curiouselectric/therm-o-nator/README.md

# therm-o-nator
A temperature sensing thermocouple amplifier kit
