curiouselectric/therm-o-nator/Thermocouple_Instructions/Thermocouple_schematic.png

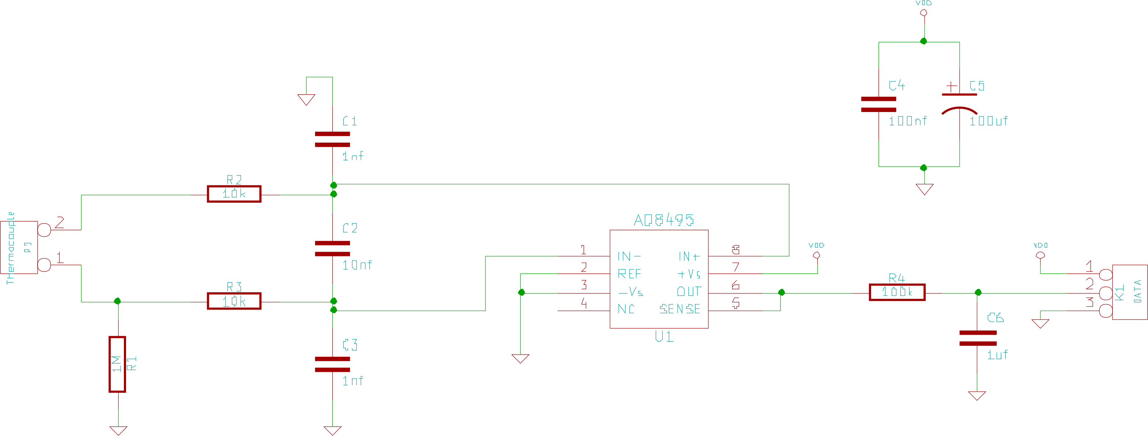
Thermocouple_Instructions/Thermocouple_schematic.png
