curiouselectric/therm-o-nator/Thermocouple_PCB/AD8495_Thermocouple_PCB_x1_30_11_13.kicad_pcb

## KiCad design Thermocouple_PCB/AD8495_Thermocouple_PCB_x1_30_11_13.kicad_pcb (2015-11-30)

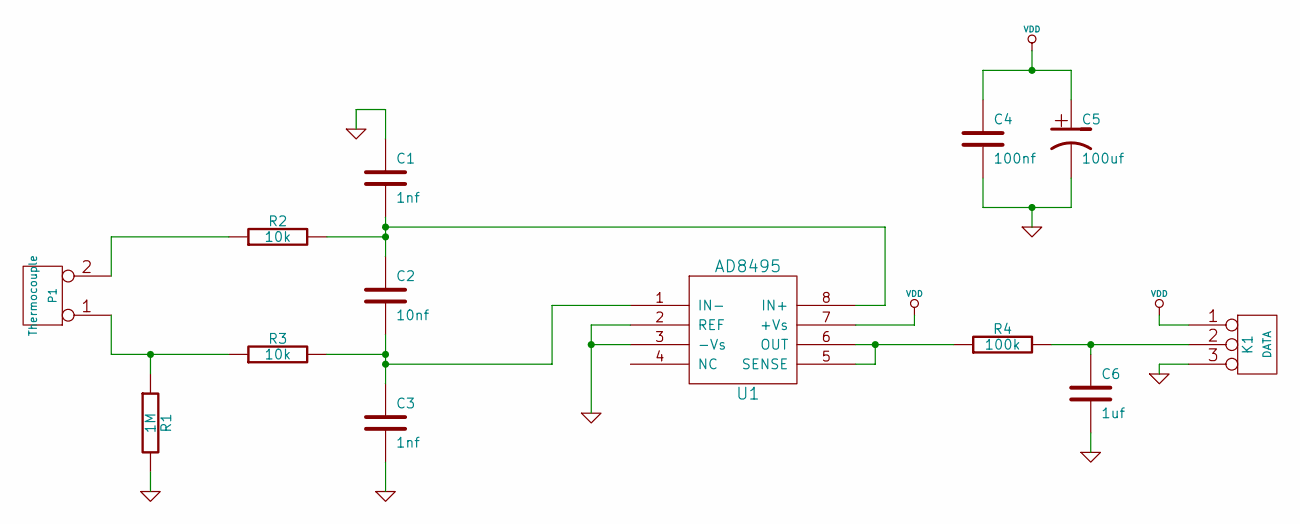
[picture p2: schematic AD8495_Thermocouple_PCB_30_11_13.sch]

Parts:
C1, C3: 1nf
C2: 10nf
C4: 100nf
C5: 100uf
C6: 1uf
K1: DATA
P1: Thermocouple
R1: 1M
R2, R3: 10k
R4: 100k
U1: AD8495

Connections:
GND: C1.1, C3.2, C4.2, C5.2, C6.2, K1.3, R1.2, U1.2 (REF), U1.3 (-Vs)
unnamed: C6.1, K1.2 (PM), R4.2
unnamed: R4.1, U1.5 (SENSE), U1.6 (OUT)
unnamed: P1.2 (PM), R2.1
unnamed: P1.1, R1.1, R3.1
unnamed: C2.2, C3.1, R3.2, U1.1 (IN-)
unnamed: C1.2, C2.1, R2.2, U1.8 (IN+)
VDD: C4.1, C5.1, K1.1, U1.7 (+Vs)

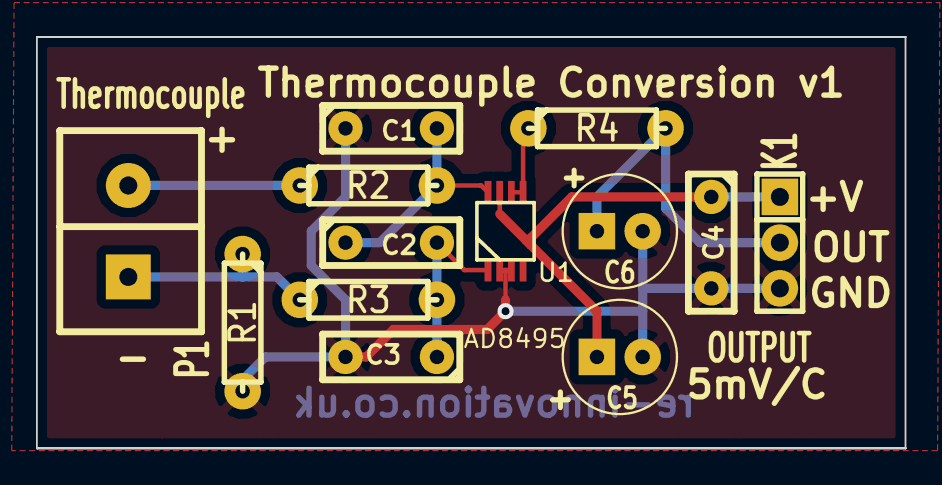
[picture p3: board AD8495_Thermocouple_PCB_x1_30_11_13.kicad_pcb from above]

Board: 2 copper layers, 48.3 x 22.9 mm, 13 parts (0 on the bottom side), 8 nets.
