curiouselectric/therm-o-nator/(commit log)

2015-11-30 Upload of files v1
    [AD8495_Thermocouple_PCB_30_11_13.brd, AD8495_Thermocouple_PCB_30_11_13.csv, AD8495_Thermocouple_PCB_30_11_13.sch, AD8495_Thermocouple_PCB_x1_30_11_13.kicad_pcb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]
2015-12-03 Initial files
    2015 12 3
    [AD8495_Thermocouple_PCB_30_11_13.csv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]
